varmps/HomeWeather/README.md

# HomeWeather
IOT sensors around the house

## Why?
So I had a punch of IOT boards and sensors and decided to do a freeform weather station. Mainly was interested in indoor humidity and CO2 levels at night. I had previously done some weather stations on breadboards and had them send data to Blynk and Thingspeak but both had their pros and cons. I wanted to have my data saved and accessible from anywhere, more freedom to costumize how data is displayed and I wanted to do it for free. So I found out I can use google scripts to put data to sheets and I do not need any server or third party software for that. 

## Weather Station nr.1
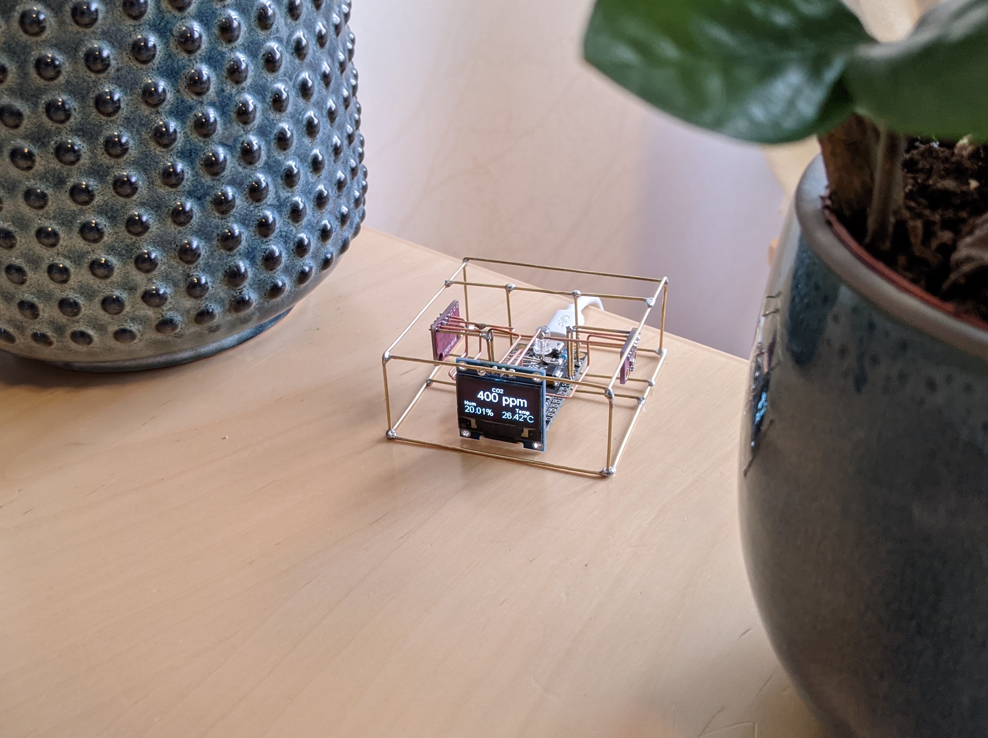
[picture p1: img/co2.jpg]


### Hardware:
- Wemos NodeMCU V3 ESP8266 dev board
- CCS811+HDC1080 CO2+TVOC and Temperature+Humidity combo board.
- BME280 Temperature+Humidity board
- SSD1306 display board

### Connections
NodeMCU | CCS811 | BME280 | SSD1306 
|---|---|---|---|
3V3 | VCC | VCC | VCC |
GND | GND | GND | GND |
D1 | SCL | SCL | SCL |
D2 | SDA | SDA | SDA |

RGB LED with resistor between NodeMCU ground and cathode, other LED legs at D6, D7, D8.

### Notes:
It seems that HDC1080 does not give correct values, probably because it is too close to CCS811, which is basically always hot. Also my BME280 does not work, not sure if it arrived dead or I killed it. Could not test it before because of the freeform plan. Until a new board arrives I am displaying HDC1080 values on the screen. The CCS811 keeps getting high peaks seemingly at random, so I added also a RGB LED to show me when it had gone "crazy" but one can also utilize the LED as some level indicator etc. I still have the 1.x.x firmware on that chip, maybe I will flash it later to see if it will be more stable then. I will first have it burn-in for a while.

## Weather Station nr.2
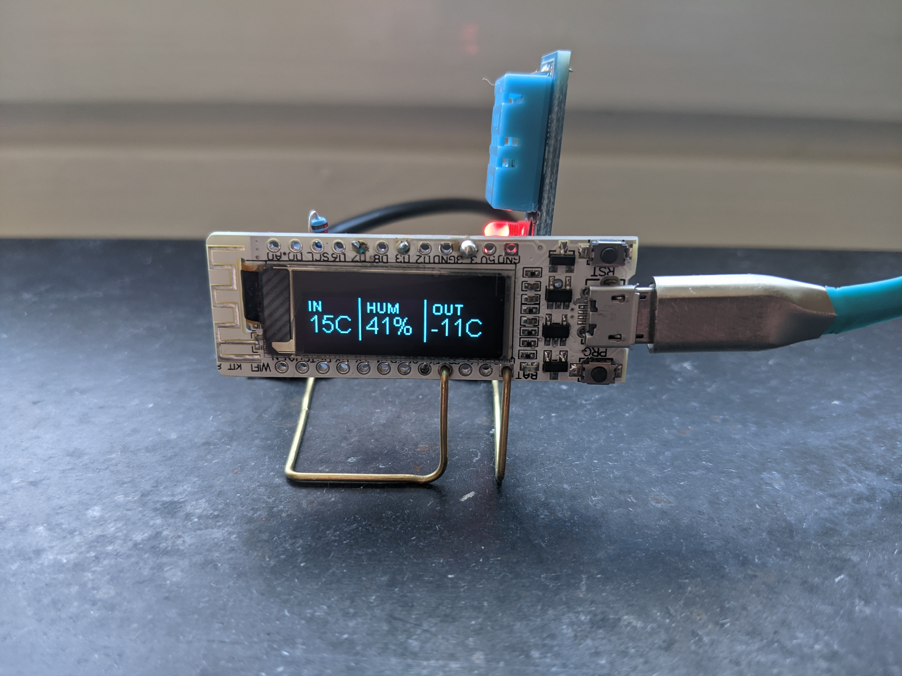
[picture p2: img/kit8.jpg]


### Hardware:
- Wifi KIT 8 Heltec ESP8266 dev board
- DHT11 Temperature+Humidity sensor
- DS18B20 Temperature sensor

### Connections
Wifi KIT 8 | DHT11 | DS18B20  
|---|---|---|
3V3 | VCC | VCC |
GND | GND | GND |
D1 | SCL | SCL |
D2 | SDA | SDA | 

Resistor between DS18B20 Data and VCC.

### Notes:
Even though even Heltec gives a link to [robotzero](https://robotzero.one/heltec-wifi-kit-8/) project on their homepage that uses U8g2 library, I had problems with it (For example flipping the screen) so I think [HelTecAutomation](https://github.com/HelTecAutomation/Heltec_ESP8266) works better. You only need to install it correctly first, which is not as straight forward as most libraries. If you have problems with DHT sensors, always check that you are not getting data too often (etc more than every 3s).

## Google Sheets
Have a Google Script added to the sheets and published as Webapp, so it gets data from both IOT devices through REST and then saves the data to Google Sheets. IOT devices are not 100% reliable and can sometimes stop sending data and then start doing it again, which means that there can be gaps in different time points. Even though every data package is saved with a timestamp, there are problems/limitations with sheets charts as time graphs give shifted graphs when one of the graphs has gaps. Graphs take the time for the x-axis (time) from one dataset and then the second dataset does not have an option for x-axis, which means that the data points of the second set are put on the same points with the first dataset. This is why I mostly check the "latest" tab for better overview.
Some better explanations about sheets:
[whatitmade](http://www.whatimade.today/log-unlimited-data-straight-to-google-sheets-from-a-bme280-temp/)
[embedded-lab](https://embedded-lab.com/blog/post-data-google-sheets-using-esp8266/)
and ofcourse [google own guides](https://developers.google.com/apps-script/guides/web)

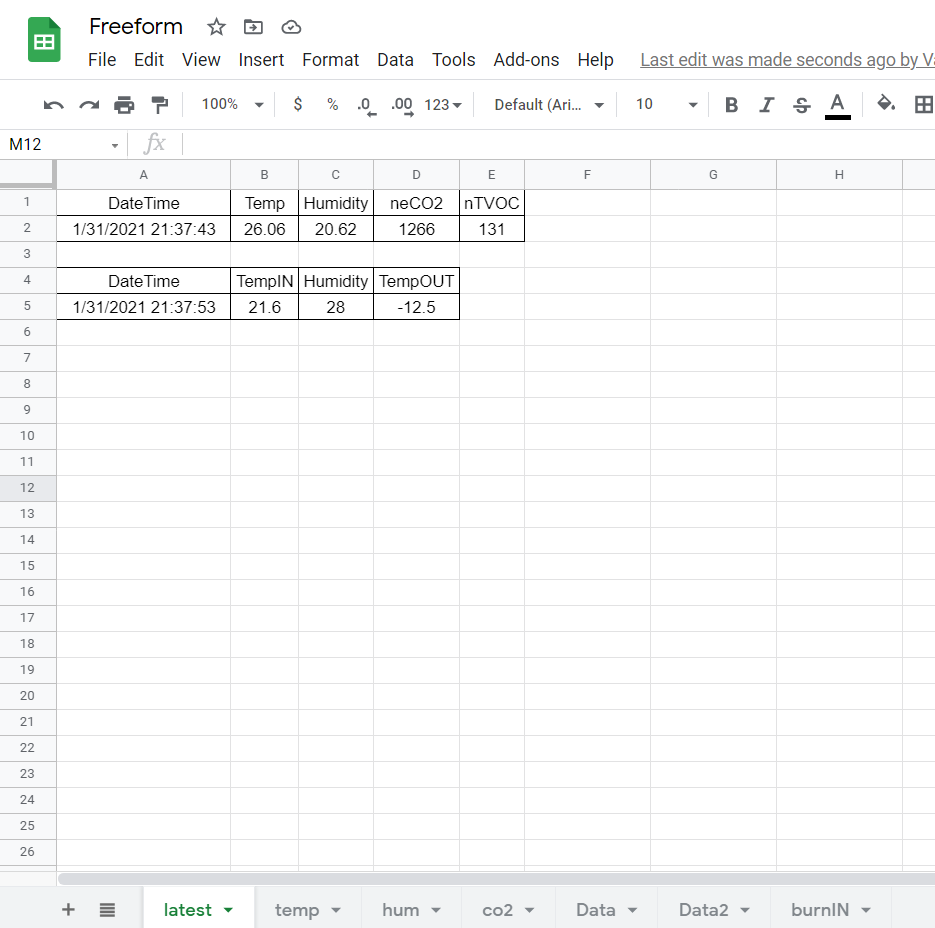
[picture p3: img/Freeform.png]

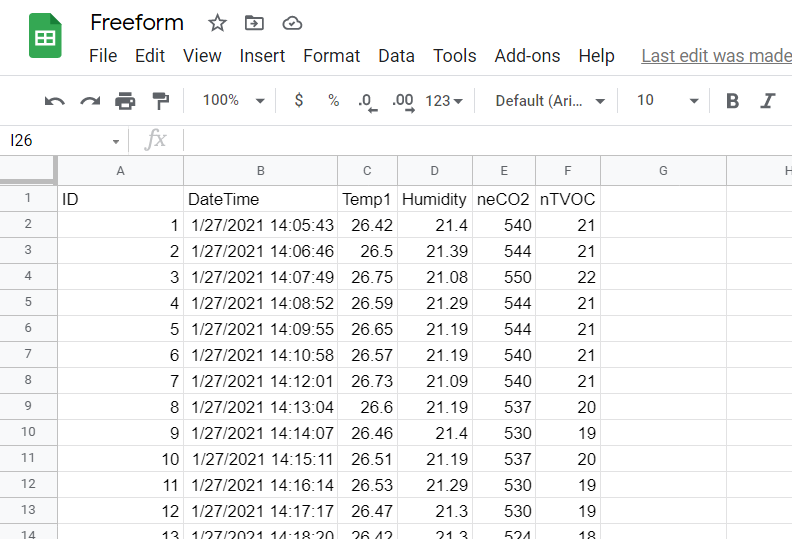
[picture p4: img/data.png]


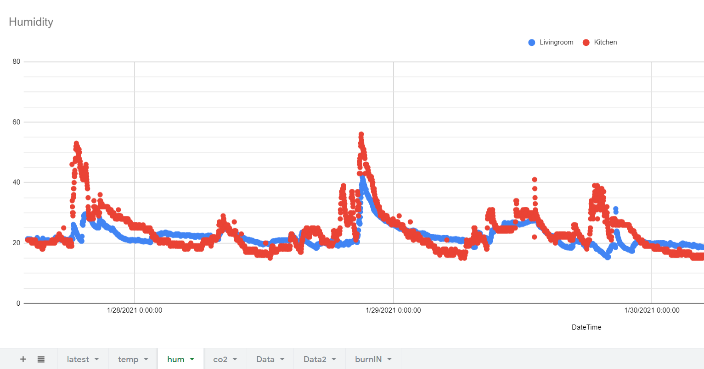
[picture p5: img/hum.png]


I have data coming from these 2 devices to tabs ("spreadsheets" or "sub-sheets" or...) Data1 and Data2, I can easily add more tabs and devices without breaking the system. Humidity, Temperature and CO2 tabs show corresponing graphs and the latest data is also updated in the "latest" tab.

### Recommended reading:
- [Mohit Bhoite](https://www.bhoite.com/sculptures/) makes some of the coolest freeform out there.
- [Maarten Pennings](https://github.com/maarten-pennings/CCS811) has made a good overview of the CCS811 sensor. Also check discussions under Issues.
- Setting up Google Sheets and your [script](https://www.electronics-lab.com/project/iot-log-sensor-data-google-sheet-using-nodemcu/). If I remember correctly then their arduino code does not work with the new libraries but the script part is nicely explained. 

### Update:
Ordered new BME280 boards, from 3 boards I ordered I got one BMP280 (thypical "scam" for cheap boards from aliexpress), one dead and one working BME280 that I changed with the faulty one I already had installed. Then I used the chance and updated the firmware of CCS811 to 2.0.1, which unfortunately did not make the measurements more stable. I do not reccomend this board. As the temp and humidity sensor values differentiate from one another quite a bit I decided to calibrate them and see if I could get some correction factors. I put all the sensors in a hermetically sealed box and made it as thermally stable as I could and added an extra thermistor for reference. Also added a bowl with saturated salt to the box for getting the 75% relative humidity value. DS18B20 ended up being the most accurate temperature sensor and DHT11 the most accurate humidity sensor. From data collected over a week I found that bme280 gave around 20% lower values, hdc1080 was very close on lower humidity values and behind on higher than 50% humidity. HDC1080 gave 5.3 deg higher, BME280 3.6 deg higher and DHT11 2.5 deg higher temperatures.
