varmps/HomeWeather/(commit log)

2021-02-09 arduino files
2021-12-01 added LED, display, correction factors do some sensors
    [NodeMCUWeather.ino]
